LucasDuarte026/drone_from_scratch/odometry/README.md

# Odometry Subsystem & 3D Flight Simulator (`odometry/`)

Real-time 3D flight telemetry visualization and C driver testbed for the quadcopter flight controller.

---

## 🏗️ Subsystem Architecture

```mermaid
flowchart LR
    subgraph DataSources ["Data Ingestion"]
        Arduino["Arduino Uno (57600 bps UART)"]
        SyntheticMock["C Synthetic Flight Kinematics"]
    end

    subgraph DriverTester ["odometry/tester.c + code/include/imu_attitude.h"]
        HAL["UART Port Scanner / Non-Blocking Poller"]
        Filter["imu_filter_rate() (0.7 / 0.3 IIR)"]
        Euler["imu_calc_euler_rates() (dt = 0.004s)"]
        Accel["imu_calc_acc_angles() (asin clamp)"]
        Comp["imu_fuse_angle() (0.9996 / 0.0004)"]
        LogWriter["odometry/logs/telemetry.log"]

        HAL --> Filter --> Euler --> Comp --> LogWriter

        Accel --> Comp
    end

    subgraph SimEngine ["Python 3D Simulator (Pygame + PyOpenGL 4x MSAA)"]
        Reader["TelemetryBuffer (10-position FIFO + Relative Timer)"]
        Model["Fictional Quad-X Drone Model (Cuboid + 4 Arms + 4 Motors + RViz Triad)"]
        HUD["UITheme Graphite 2-Bar HUD (Top Instrument Bar + Bottom Layer Dock + Telemetry Drawer)"]

        Reader --> Model
        Reader --> HUD
    end

    DataSources --> HAL
    LogWriter -->|Real-time Tail Ingestion| Reader
```

---

## 🚀 Quickstart Guide

### 1. Launch the 3D Visualizer (`sim3d`)

You can launch the visualizer directly with `./sim3d`:

- **Real Hardware Serial Mode (Default — direct ingestion from USB):**
  ```bash
  ./sim3d
  # Or explicitly:
  ./sim3d --serialplot
  ./sim3d --serialplot --port /dev/ttyUSB0 --baud 57600
  ```

- **Synthetic Mock Mode (using C kinematics simulation):**
  ```bash
  ./sim3d --mock
  ```

---

### 2. Standalone C Driver Tester (`odometry/tester`)

If you want to run the low-level C harness independently (directly sharing `code/include/imu_attitude.h` via `-I../code/include`):
- **Build C Tester:**
  ```bash
  make -C odometry
  ```
- **Run C Tester (Hardware Serial):**
  ```bash
  ./odometry/tester
  ```
- **Run C Tester (Synthetic Mock):**
  ```bash
  ./odometry/tester -m
  ```

---

## 🎨 UI Architecture & Anti-AI Slop Design System (`UITheme`)

The 3D simulator interface was redesigned using knowledge synthesized from three architectural sources:
1. **World Info Vault (`Impeccable` Anti-AI Slop Principles)**:
   - Removed saturated neon cyan/green borders (`1px`), `bold=True` across all fonts, and ASCII pseudo-icons (`[✓]`, `[ ]`, `⌂`, `▼`).
   - Replaced scattered floating overlays with a structured **2-Bar Instrument Layout** (`TOP_BAR_HEIGHT = 52px`, compact bottom dock `DOCK_PILL_HEIGHT = 24px`, `DOCK_PILL_WIDTH = 74px`).
2. **Agency UI Designer & UX Architect Personas (`UITheme` Token System)**:
   - **Neutral Graphite Surfaces**: Deep canvas `(0.07, 0.08, 0.10)`, translucent slate panels `(22, 25, 32, 232)`, latest-row highlight `(38, 46, 60, 225)`, subtle borders `(56, 62, 76, 215)`, and internal hairline dividers `(48, 54, 68, 200)`.
   - **Interactive States**: Distinct `BTN_IDLE`, `BTN_HOVER` (mouse hover tracking), and `BTN_ACTIVE` `(56, 68, 90, 248)` with `BORDER_ACTIVE` `(98, 120, 158, 240)`.
   - **High-DPI Typography & Tabular Hierarchy (English-Only UI Standard)**: All UI labels, status strings, and table columns are standardized in English. Native Linux geometric sans (`DejaVu Sans,Ubuntu`, `14px`–`17px` regular) is used for muted uppercase labels and controls, paired with tabular monospace (`DejaVu Sans Mono,Ubuntu Mono`, `22px` bold for primary `ROLL`/`PITCH`/`YAW` readouts and `16px` for the 5-column `460px` telemetry drawer: `SAMPLE`, `TIME`, `ROLL`, `PITCH`, `YAW`) so numeric updates at 25 Hz never jitter horizontally.
   - **Relative Session Time (`format_sample_time`)**: Converts raw 13-digit Unix epoch timestamps or simulation ms into clean relative session seconds (`12.4s`).
3. **Context7 (`Pygame` & `PyOpenGL` Hardware Anti-Aliasing)**:
   - **OpenGL 4x MSAA & Line Smoothing**: Configures `GL_MULTISAMPLEBUFFERS = 1` and `GL_MULTISAMPLESAMPLES = 4` prior to window creation (with graceful fallback), alongside `glEnable(GL_MULTISAMPLE)`, `glEnable(GL_LINE_SMOOTH)`, and `glHint(GL_LINE_SMOOTH_HINT, GL_NICEST)`.
   - **2D Vector Anti-Aliasing (`pygame.gfxdraw`)**: Renders smooth status indicator dots (`gfxdraw.aacircle` + `gfxdraw.filled_circle`) with a soft outer halo.

---

## 🎮 Simulator Controls & HUD Features (English Default)

| Feature | Control / Interaction | Description |
| :--- | :--- | :--- |
| **Orbit Camera** | Left-Click + Drag | Rotates the viewpoint freely around the quadcopter (Azimuth & Elevation). |
| **Pan Camera** | Right-Click + Drag | Shifts the scene focal center. |
| **Zoom In / Out** | Mouse Wheel | Moves camera closer to or farther from the drone. |
| **Serial Port Release**| Click Top-Left Status Pill or press `S` | Toggles serial connection (`Online · ttyUSBx` $\leftrightarrow$ `Port Free · ttyUSBx [S]`) to free the USB port for PlatformIO firmware uploads. |
| **Reset View** | Click **`H Reset`** or press `H` | Instantly restores camera to default isometric view ($45^\circ / 30^\circ$). |
| **Calibrate IMU** | Click **`R Calibrate`** or press `R` | Sends `'C\n'` recalibration command over serial to the Arduino and zeroes the 3D attitude pose. |
| **Projection Toggle**| Click **`P Perspective` / `P Isometric`** or press `P` | Switches between Orthographic Isometric and Perspective projections. |
| **Telemetry Drawer**| Click **`C Telemetry`** or press `C` | Collapses or expands the right-hand 5-column tabular drawer (`SAMPLE`, `TIME`, `ROLL`, `PITCH`, `YAW`) showing the 10-position FIFO buffer. |
| **Attitude Readout**| Top-Center 3-Column Bar | High-DPI `22px` tabular monospace readout for live **ROLL**, **PITCH**, and **YAW**. |
| **RViz IMU Axes**| Center Origin Triad | **3D Orthogonal Axes at IMU Center**: Red = +X (Nose), Green = +Y (Right), Blue = +Z (Down/Vertical). |
| **Bottom Layer Dock**| Click Dock Pills or Keys `1`–`5`| **Individual Layer Toggles**: `1 Body` · `2 Arms` · `3 Motors` · `4 Axes` · `5 Grid`. |
| **Drone Manipulability**| None | **Non-manipulable**: Drone attitude (Roll, Pitch, Yaw) is 100% driven by telemetry. |

---

## 🧪 TDD Test Suite

All parsing, FIFO eviction, timeout tracking, and 3D kinematics are verified through automated Pytest suites:
```bash
PYTHONPATH=. .venv/bin/pytest odometry/tests/
```
