LucasDuarte026/drone_from_scratch/(commit log)

2026-10-22 insert of git ignore
2026-10-27 feat(imu): add generic I2C bus scanner and 6-value attitude-accel telemetry
    - Add standalone device-agnostic I2C scanner and A4/A5 pull-up checker (code/src/i2c_finder.cpp)
    - Unify platformio.ini environments into [env:uno] and [env:i2c_finder] with shared serial port config
    - Stream 25 Hz Roll, Pitch, Yaw, and scaled AccX/AccY/AccZ (g) in code/src/main.cpp
    OpenSpec: stage-1-imu-implementation
2026-10-27 feat(odometry): implement Graphite UITheme, 4x MSAA viewport, and direct USB serial worker
    - Redesign 3D simulator HUD with Anti-AI Slop UITheme tokens, High-DPI typography, and 2-bar layout
    - Enable OpenGL 4x MSAA, GL_LINE_SMOOTH, and pygame.gfxdraw anti-aliased status indicators
    - Add RViz IMU coordinate triad, inertial position estimator, fading trail, and component visibility dock
    - Add SerialTelemetryWorker with live USB port auto-scan, platformio.ini sync, and calibration command queue
    - Refactor odometry/tester.c to directly include canonical code/include/imu_attitude.h
    - Add sim3d CLI launcher and expand Pytest TDD suite to 20 unit tests
    OpenSpec: odometry-3d-simulation
2026-10-27 docs(release): bump version to 0.4.0 and document UITheme and SDD architecture
    - Update VERSION and docs/CHANGELOG.md for release 0.4.0
    - Document UITheme design system, 4x MSAA pipeline, and shared IMU math header in system_architecture.md and odometry/README.md
    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
2026-10-27 refactor(odometry): standardize 3D simulator UI and status messages in English
    - Translate all HUD controls, table headers, layer dock pills, and serial statuses to English
    - Add test_english_only_ui_labels in odometry/tests/test_drone_model.py to enforce English UI standard
    - Document mandatory English-only UI and documentation standard across SDD docs
    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
2026-10-28 feat(odometry): implement ZUPT, full-precision kinematics, and dual-tier telemetry logger
    - Add Zero-Velocity Update (ZUPT) in InertialPositionEstimator to extinguish velocity integration runaway
    - Configure 0.05g stationary noise deadband and unconstrained float64 kinematics by default
    - Implement dual-tier TelemetryLogger with 1 Hz heartbeat and verbose (-v) per-sample forensic stream
    - Add calibration warning modal overlay with live countdown and kinematic integration pause
    - Add 3D Velocity (VEL 3D) readout row to simulator HUD odometry panel
    - Calibrate accelerometer source biases (acc_bias) and latch 10-tick average at Tick 5 in main.cpp
    - Emit 4-decimal acceleration telemetry ov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
2026-11-02 docs(release): restructure workspace into project_1/2 and establish open-source documentation hierarchy
    - Restructure repository into project_1 (physical bench) and project_2 (firmware architecture & odometry research)
    - Author comprehensive root README.md with Shields.io badges, academic metadata (USP/EESC), and YouTube video card
    - Author project_1/README.md with hardware pinouts, stepper motor theory, example_01.ino bug fixes, and RF protocol
    - Expand project_2/README.md with formal proof of quadratic odometry divergence (0.5*b_a*t^2) and Kalman filter requirements
    - Establish docs/KNOWLEDGE_GAPS_REPORT.md and isolated OpenSpec governance (ephemeral release invariant)
    OpenSpec: globa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
2026-11-03 docs(media): embed project 2 3d simulation screenshot and youtube video demo
    - Insert 3d_simulation.png interface screenshot in project_2/README.md and root README.md
    - Embed clickable YouTube Shorts card (7p0rP1CsYMk) demonstrating live attitude tracking
    - Mark multimedia assets as resolved in docs/KNOWLEDGE_GAPS_REPORT.md and update CHANGELOG.md
