LucasDuarte026/drone_from_scratch/(notices)

Notices in the files:
README.md:
License: MIT
